VeroLR/LocalizacionMascota/README.md

# Sistema electrónico para la geolocalización de mascotas
 Trabajo Fin de Grado - Verónica Lechón Rodríguez

 Para consultar la documentación de la aplicación, acceda al siguiente enlace: https://verolr.github.io/LocalizacionMascota
