VeroLR/LocalizacionMascota/Software/NodoUsuario/docs_mainpage.md

# Sistema de localización de mascotas basado en LoRa

Este sitio recoge la documentación técnica del firmware del **nodo de usuario**:
- Recepción LoRa (SX1262 via RadioLib)
- Gestión WiFi (STA/AP) y portal (LittleFS + WebServer)
- Interfaz LCD (HD44780 I²C)

## Módulos
- \ref group_gps "gps_handler"
- \ref group_lora_rx "lora_handler (RX)"
- \ref group_wifi "wifi_manager"
- \ref group_html "html_pages (portal web)"
- \ref group_lcd "lcd_utils (LCD)"

## Licencia y contacto
Autor/a: Verónica Lechón Rodríguez
