VeroLR/LocalizacionMascota/Hardware/Proteus/ProyectoTFG/Esquematico.PDF

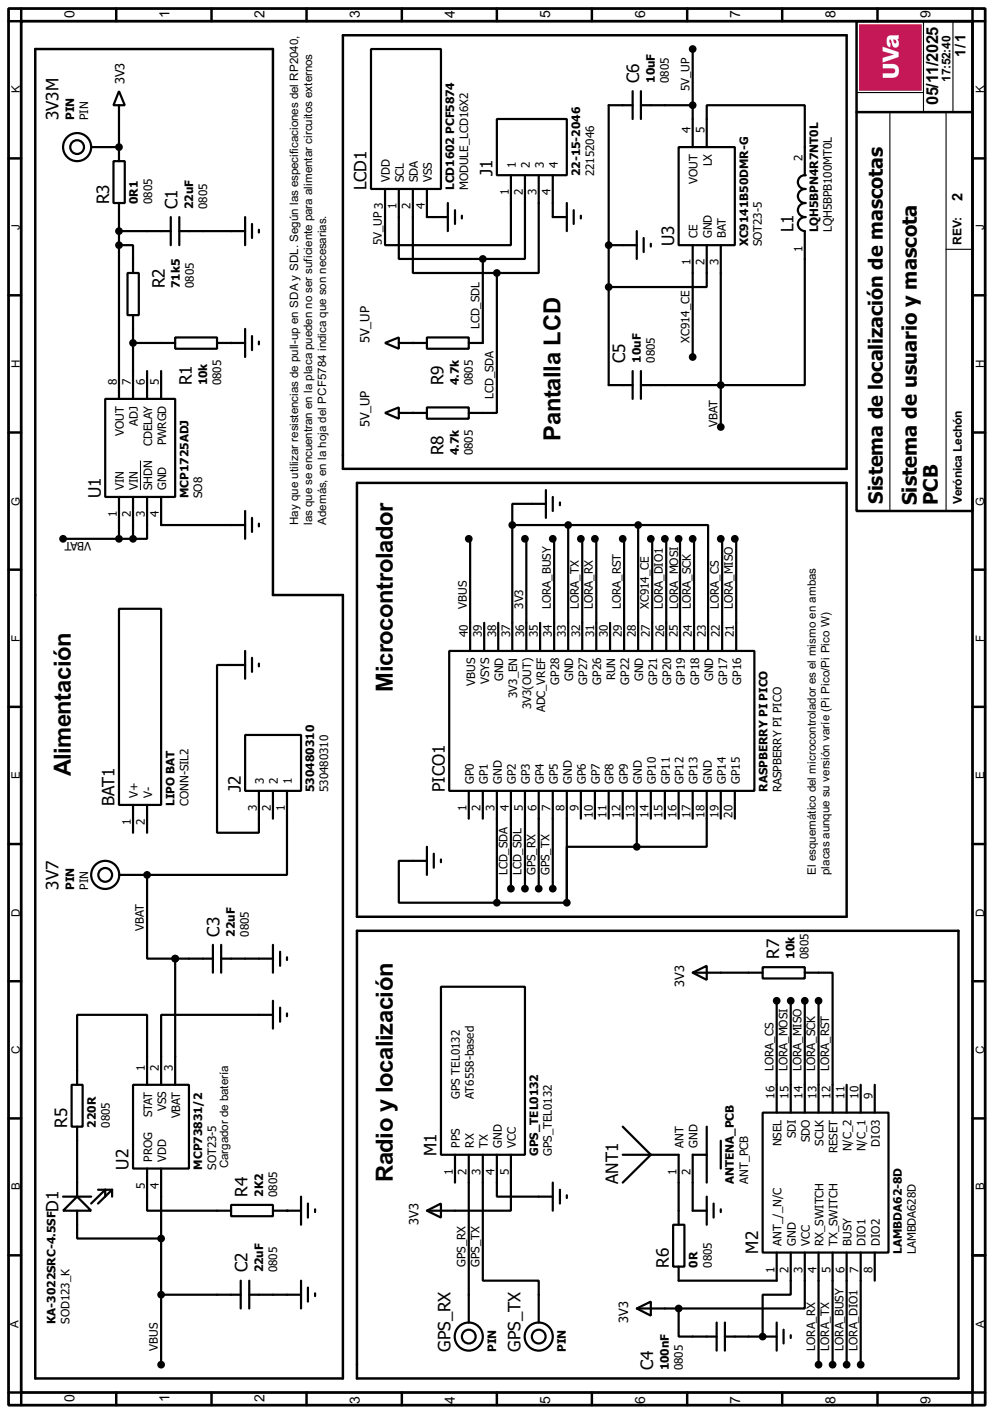
[picture p2: page 1]

Hay que utilizar resistencias de pull-up en SDA y SDL. Según las especificaciones del RP2040,

las que se encuentran en la placa pueden no ser suficiente para alimentar circuitos externos Además, en la hoja del PCF5784 indica que son necesarias.

El esquemático del microcontrolador es el mismo en ambas placas aunque su versión varíe (Pi Pico/Pi Pico W)
