VeroLR/LocalizacionMascota/ModeloConsumo/ModeloConsumo.pdf

Periodo T (s) Eventos n(T) | Umcu | Consumo mCU (Pi Pico) Consumo LoRa | Iquiesc DC-DC | LCD (con backlight)
30 | 120,0 | 0,33333 | 72,00 | 4,6 | 0,17 | 25
60 | 60,0 | 0,16667 | 72,00 | 4,6 | 0,17 | 25
180 | 20,0 | 0,05556 | 72,00 | 4,6 | 0,17 | 25
360 | 10,0 | 0,02778 | 72,00 | 4,6 | 0,17 | 25
600 | 6,0 | 0,01667 | 72,00 | 4,6 | 0,17 | 25
1200 | 3,0 | 0,00833 | 72,00 | 4,6 | 0,17 | 25
1800 | 2,0 | 0,00556 | 72,00 | 4,6 | 0,17 | 25
2400 | 1,5 | 0,00417 | 72,00 | 4,6 | 0,17 | 25
3000 | 1,2 | 0,00333 | 72,00 | 4,6 | 0,17 | 25
3600 | 1,0 | 0,00278 | 72,00 | 4,6 | 0,17 | 25
Media | | 0,06242 | 72,00 | 4,6 | 0,17 | 25
W | 3600 | s
Irx 4,6 mA | Iact 72 mA | C 2000 mAh
ToA 0,1648 s | Iidle 72 mA | LCD (backlight) 25 mA
uact | 5 | s | LCD (sin backlight)
Periodo T (s) I_avg (T) (mA) Autonomía (h) Autonomía (días) | C (mAh) | Autonomía(h) | Autonomía (días)
30 | 101,77 | 19,65 | 0,82 | 500 | 4,91 | 0,20
60 | 101,77 | 19,65 | 0,82 | 700 | 6,88 | 0,29
180 | 101,77 | 19,65 | 0,82 | 900 | 8,84 | 0,37
360 | 101,77 | 19,65 | 0,82 | 1000 | 9,83 | 0,41
600 | 101,77 | 19,65 | 0,82 | 1500 | 14,74 | 0,61
1200 | 101,77 | 19,65 | 0,82 | 2000 | 19,65 | 0,82
1800 | 101,77 | 19,65 | 0,82 | 3000 | 29,48 | 1,23
2400 | 101,77 | 19,65 | 0,82 | 4000 | 39,30 | 1,64
3000 | 101,77 | 19,65 | 0,82
3600 | 101,77 | 19,65 | 0,82
Media | 101,77 | 19,65 | 0,82

# CONSUMO ENERGÉTICO DEL NODO DE USUARIO (SIN OPTIMIZACIÓN ENERGÉTICA)

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
500 | 700 | 900 | 1000 | 1500 | 2000 | 3000 | 4000

## Autonomía en horas según la capacidad de la batería elegida

Autonomía(h)

## OPTIMIZACIÓN ENERGÉTICA DEL NODO DE USUARIO

## Horas de autonomía (h) frente a Periodo de actualización T (s)

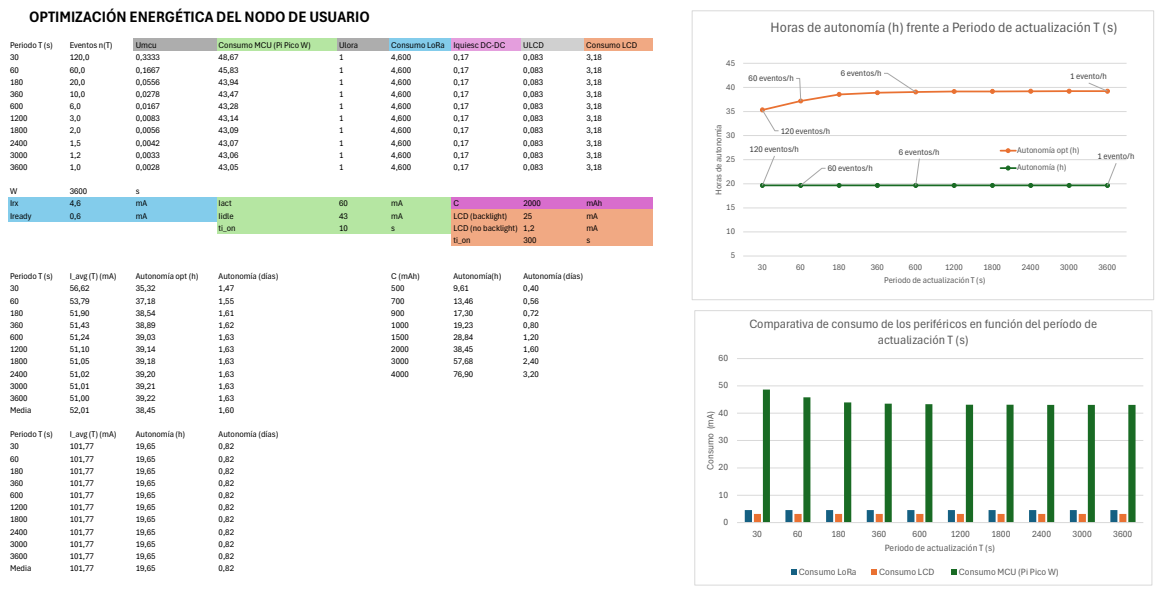
[picture p3: page 2]
Periodo T (s); Eventos n(T); Umcu; Consumo MCU (Pi Pico W); Ulora; Consumo LoRa Iquiesc DC-DC; ULCD; Consumo LCD; Irx; Iact; mAh; Iready; Iidle; LCD (backlight); LCD (no backlight) 1,2; I_avg (T) (mA); Autonomía opt (h); Autonomía (días); C (mAh); Autonomía(h); Media; Autonomía (h); 120 eventos/h; 60 eventos/h; 6 eventos/h; 1 evento/h; 3600 Horas de autonomía; 3600 Consumo ⁽mA⁾; actualización T (s); Consumo LoRa

Periodo de actualización T (s)

Comparativa de consumo de los periféricos en función del período de

Periodo T (s) | Eventos n(T) | Ulora | Consumo LoRa | Ugnss | Consumo GNSS | Umcu | Consumo mCU (Pi Pico) | Iquiesc
30 | 120 | 0,005493333 1,69 | 1 | 25,00 | 1 | 25,00 | 0,12
60 | 60 | 0,002746667 1,44 | 1 | 25,00 | 1 | 25,00 | 0,12
180 | 20 | 0,000915556 1,28 | 1 | 25,00 | 1 | 25,00 | 0,12
360 | 10 | 0,000457778 1,24 | 1 | 25,00 | 1 | 25,00 | 0,12
600 | 6 | 0,000274667 1,22 | 1 | 25,00 | 1 | 25,00 | 0,12
1200 | 3 | 0,000137333 1,21 | 1 | 25,00 | 1 | 25,00 | 0,12
1800 | 2 | 9,15556E-05 1,21 | 1 | 25,00 | 1 | 25,00 | 0,12
2400 | 1,5 | 6,86667E-05 1,21 | 1 | 25,00 | 1 | 25,00 | 0,12
3000 | 1,5 | 6,86667E-05 1,21 | 1 | 25,00 | 1 | 25,00 | 0,12
3599 | 1 | 4,57778E-05 1,20 | 1 | 25,00 | 1 | 25,00 | 0,12

W 3600 s
Itx @ 14 dBm | | 90 mA | Iacq | | 25 mA | Iact | | 25 mA
ToA | 0,1648 s | Itrack | 25 mA | Iidle | 9 mA
Iidle | | 1,2 mA | tTTFF | | 32 s | tmcuact | | 10 s
| | | Isleep | | 0,001 mA
| | | ttrack | | 10 s
Periodo T (s) | Iavg (T) (mA) | Autonomía (h) Autonomía (días) | C | 2000 mAh
30 | 51,69 | 38,69 | 1,61
60 | 51,44 | 38,88 | 1,62
180 | 51,28 | 39,00 | 1,63
360 | 51,24 | 39,03 | 1,63
600 | 51,22 | 39,04 | 1,63
1200 | 51,21 | 39,05 | 1,63
1800 | 51,21 | 39,06 | 1,63
2400 | 51,21 | 39,06 | 1,63
3000 | 51,21 | 39,06 | 1,63
3599 | 51,20 | 39,06 | 1,63
Media | 51,29 | 38,99 | 1,62

# CONSUMO ENERGÉTICO DEL NODO DE LA MASCOTA (SIN OPTIMIZACIÓN ENERGÉTICA)

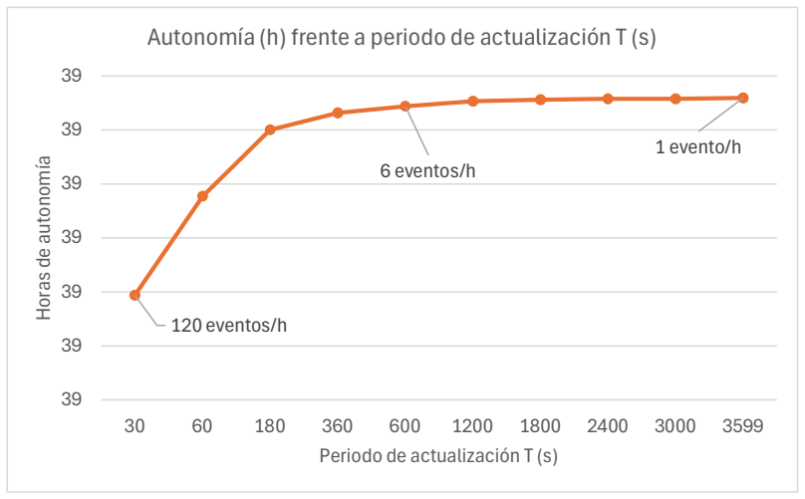
[picture p4: figure]
120 eventos/h; 6 eventos/h; 1 evento/h; Periodo de actualización T (s)

30 | 60 | 180 | 360 | 600 | 1200 1800 2400 3000 3599 Horas de autonomía

## Autonomía (h) frente a periodo de actualización T (s)

# OPTIMIZACIÓN ENERGÉTICA DEL NODO DE LA MASCOTA

## Autonomía (horas) frente al periodo de

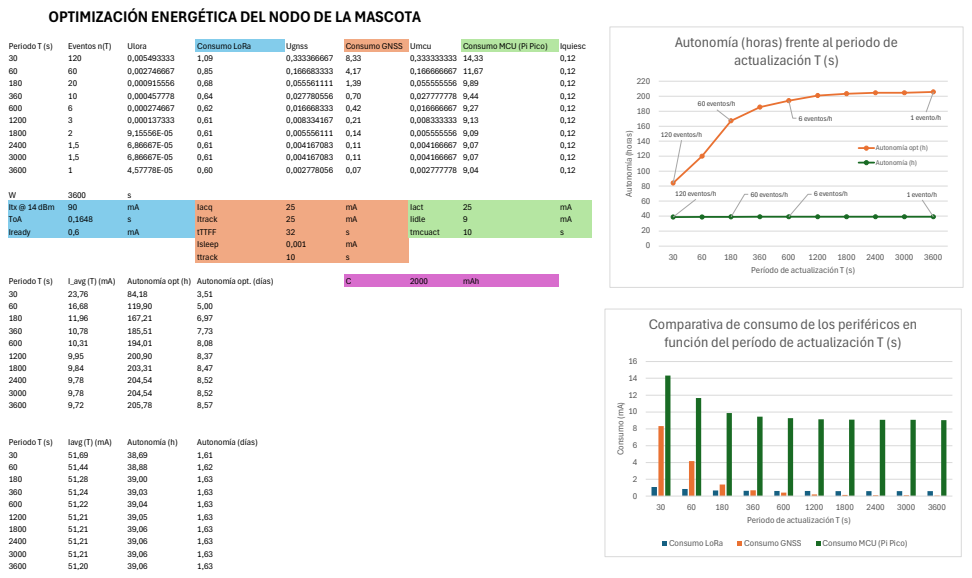
[picture p5: page 4]
Periodo T (s); Eventos n(T); Ulora; Consumo LoRa; Ugnss; Consumo GNSS Umcu; Consumo MCU (Pi Pico) Iquiesc; Itx @ 14 dBm; Iacq; Iact; ToA; Itrack; Iidle; Iready; tTTFF; tmcuact; Isleep; ttrack; I_avg (T) (mA) Autonomía opt (h) Autonomía opt. (días); mAh; Iavg (T) (mA); Autonomía (h); Autonomía (días); 120 eventos/h; 60 eventos/h; 6 eventos/h; 1 evento/h; 1 evento/h 0; 1200 1800 2400 3000 3600 Autonomía ⁽horas⁾; actualización T (s); Autonomía opt (h); 1200 1800 2400 3000 3600 Consumo ⁽mA⁾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

Período de actualización T (s)

Comparativa de consumo de los periféricos en

Periodo de actualización T (s)
