VeroLR/LocalizacionMascota/(list of files, drawings)

Other design files:
Hardware/Proteus/ProyectoTFG/ProyectoTFG.pdsprj
