VeroLR/LocalizacionMascota/(commit log)

2025-10-30 Organización proyecto
    [Bill Of Materials Sistema de localización de mascotas.csv, EstudioConsumo.xlsx, LCD-16X2.step, PCF8574T.step, ProyectoTFG [20250902, 10-49-43].pdsprj, ProyectoTFG [20250904, 13-32-28].pdsprj, ProyectoTFG [20250910, 20-20-43].pdsprj, ProyectoTFG [20250929, 19-26-55].pdsprj]
2025-10-30 Librerías
    [ProyectoTFG.DXF]
2025-11-03 Actualización directorio hardware
    [LCD-16X2.step, PCF8574T.step, ProyectoTFG [20250902, 10-49-43].pdsprj, ProyectoTFG [20250904, 13-32-28].pdsprj, ProyectoTFG [20250910, 20-20-43].pdsprj, ProyectoTFG [20250929, 19-26-55].pdsprj, ProyectoTFG [20250929, 19-28-07].pdsprj, ProyectoTFG [20250929, 23-54-17].pdsprj]
2025-11-03 Update estudioconsumo
    [EstudioConsumo.xlsx]
2025-11-03 EstudioConsumo pdf
    [EstudioConsumo.xlsx]
2025-11-05 Modificación y actualización de algunos ficheros
    [Bill Of Materials Sistema de localización de mascotas.csv, ProyectoTFG.pdsprj]
